itsdavidgarzon/EASE/Website/images/headshots/Alex.png

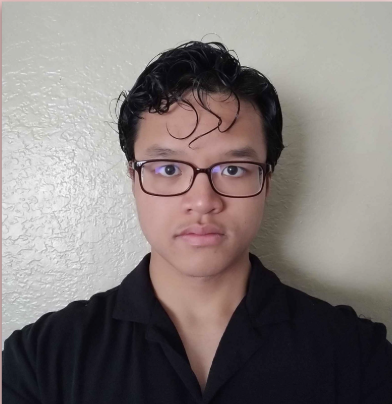
Website/images/headshots/Alex.png
