itsdavidgarzon/EASE/Website/images/headshots/Matthew.png

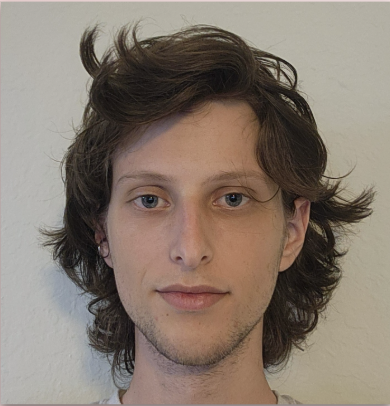
Website/images/headshots/Matthew.png
