itsdavidgarzon/EASE/Website/images/headshots/David.png

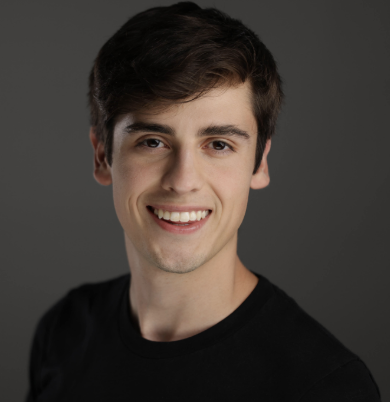
Website/images/headshots/David.png
