itsdavidgarzon/EASE/Website/images/headshots/Dillon.png

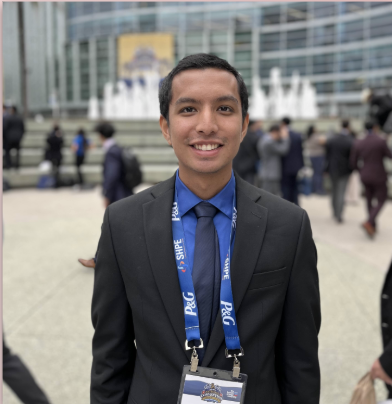
Website/images/headshots/Dillon.png
